JoeGould1878/spectrum_visualiser_lab/docs/evidence/plots/2026-11-05_first_run_frames.png

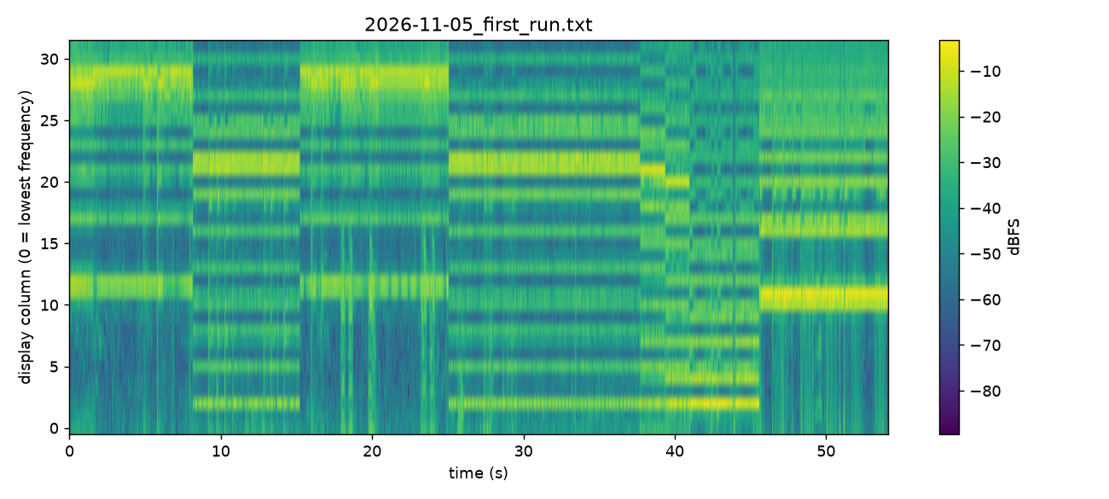
docs/evidence/plots/2026-11-05_first_run_frames.png
