JoeGould1878/spectrum_visualiser_lab/docs/evidence/README.md

# Evidence

Everything here can be cited in reflections, the report and the demo.

| Folder | What goes in it | Name like |
| --- | --- | --- |
| `logs/` | serial captures (`idf.py monitor \| tee`) | `2026-11-03_02_rate_40k.txt` |
| `photos/` | setups, display states, wiring | `2026-11-03_01_staircase.jpg` |
| `videos/` | latency clap, music demo, aliasing demo | `2026-11-10_aliasing_filter_off.mp4` |
| `plots/` | charts made by `tools/` | `2026-11-10_freq_response.png` |

Date first so files sort in order. Mention the file name in `docs/CONTEXT.md` or the decision log when it backs a decision.

Large videos: keep them out of git if they're over ~50 MB (GitHub limit is 100 MB) — upload to Canvas and put the link here instead.
