JoeGould1878/spectrum_visualiser_lab/docs/diagrams/circuit.png

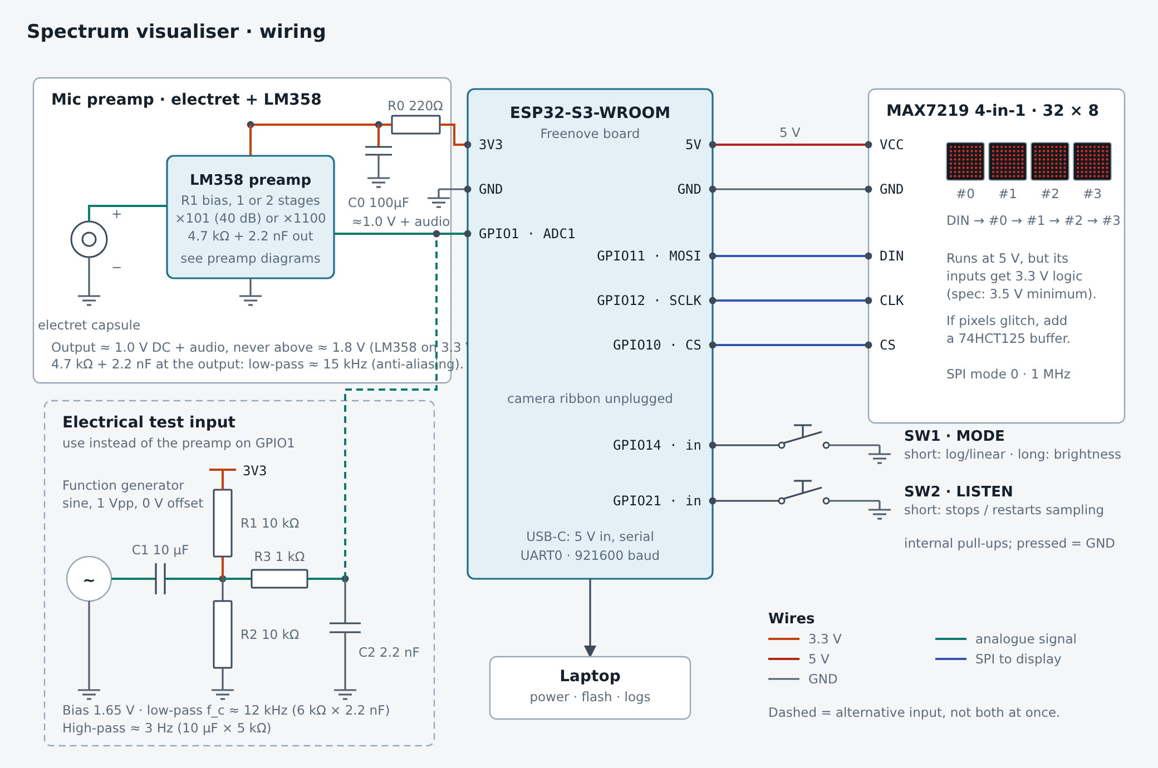
docs/diagrams/circuit.png
