JoeGould1878/spectrum_visualiser_lab/docs/diagrams/fw-detail.png

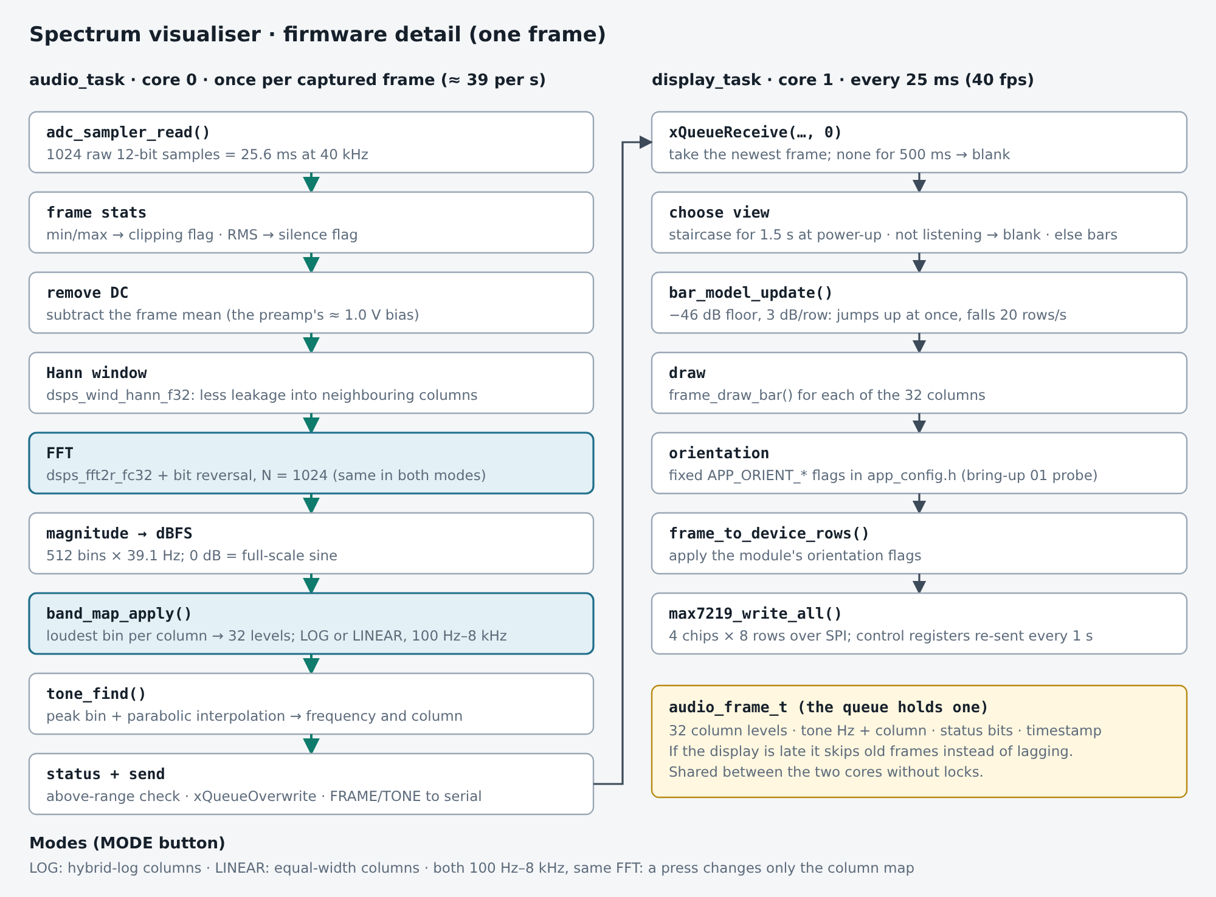
docs/diagrams/fw-detail.png
