JoeGould1878/spectrum_visualiser_lab/docs/diagrams/fw-flow.png

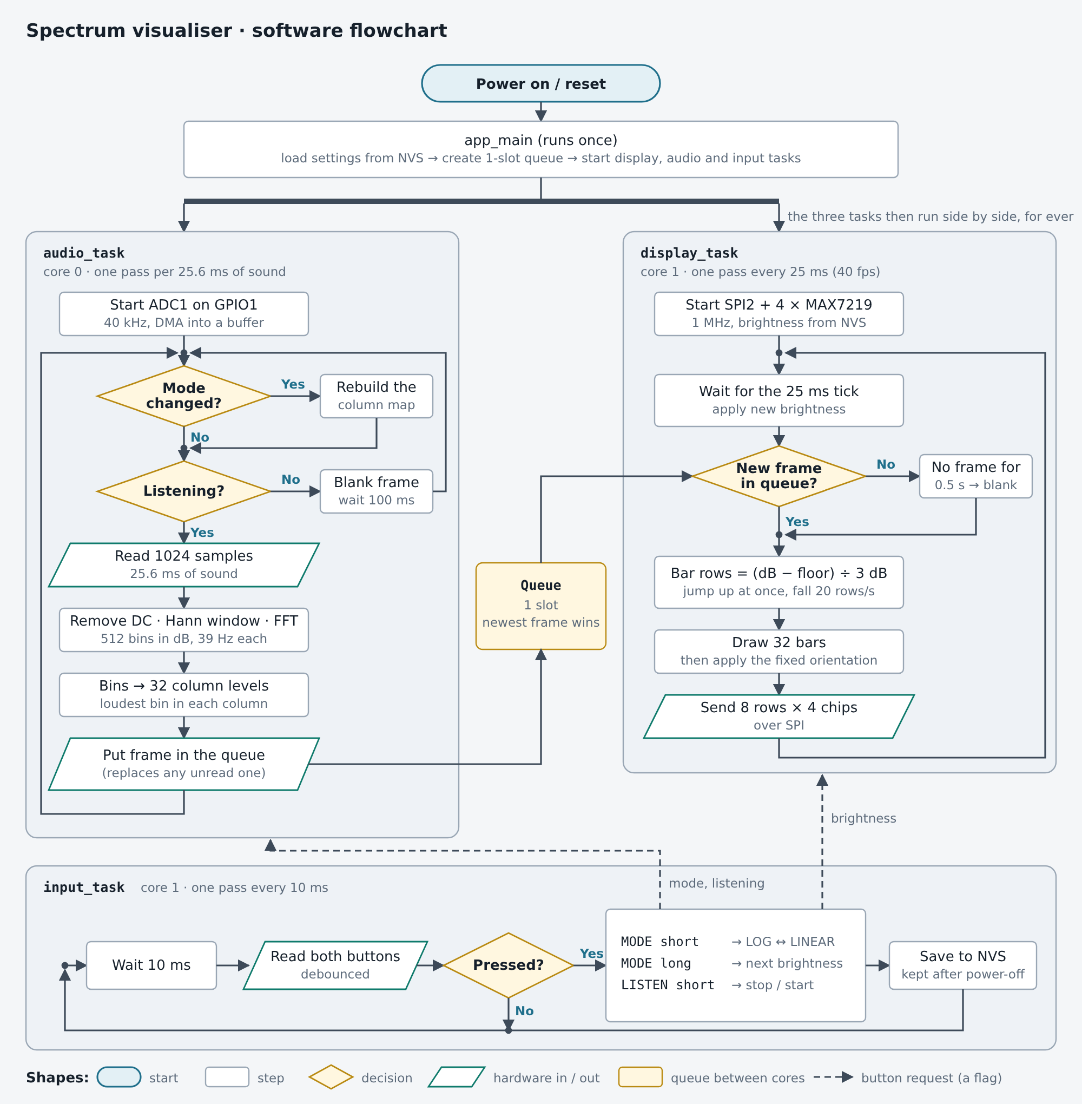
docs/diagrams/fw-flow.png
