JoeGould1878/spectrum_visualiser_lab/docs/diagrams/fw-overview.png

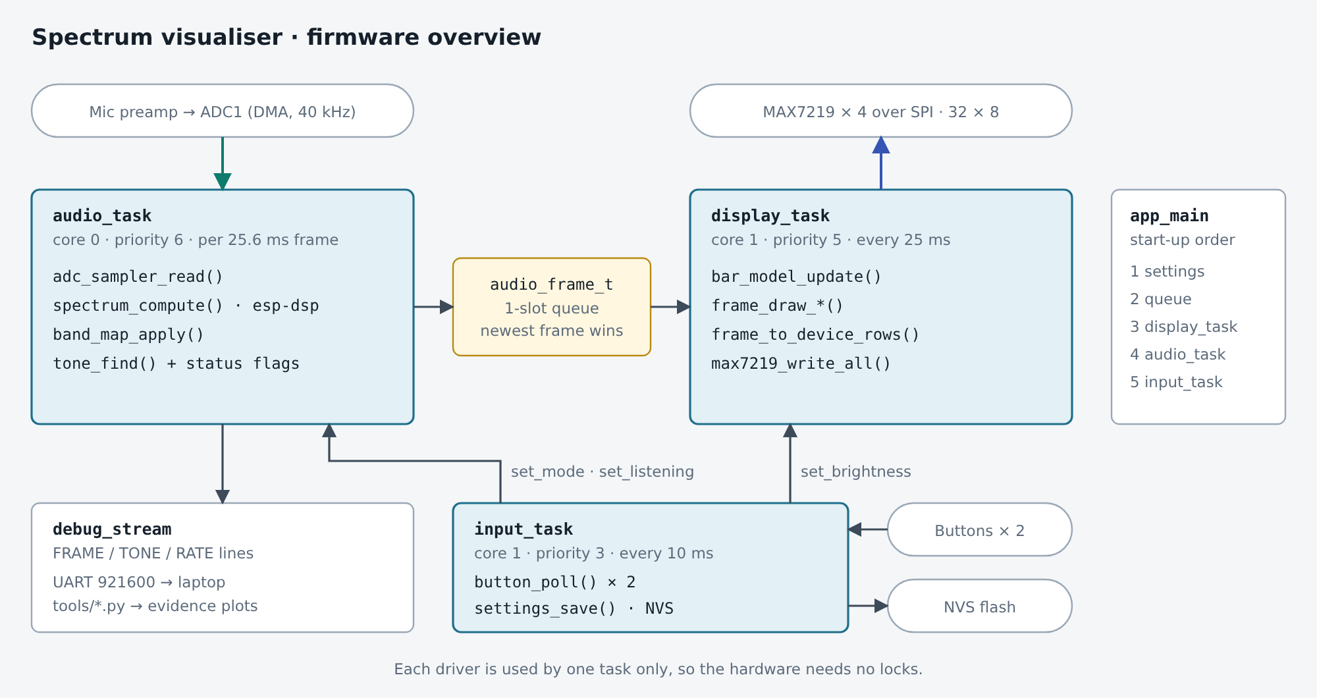
docs/diagrams/fw-overview.png
