JoeGould1878/spectrum_visualiser_lab/docs/diagrams/hw-detail.png

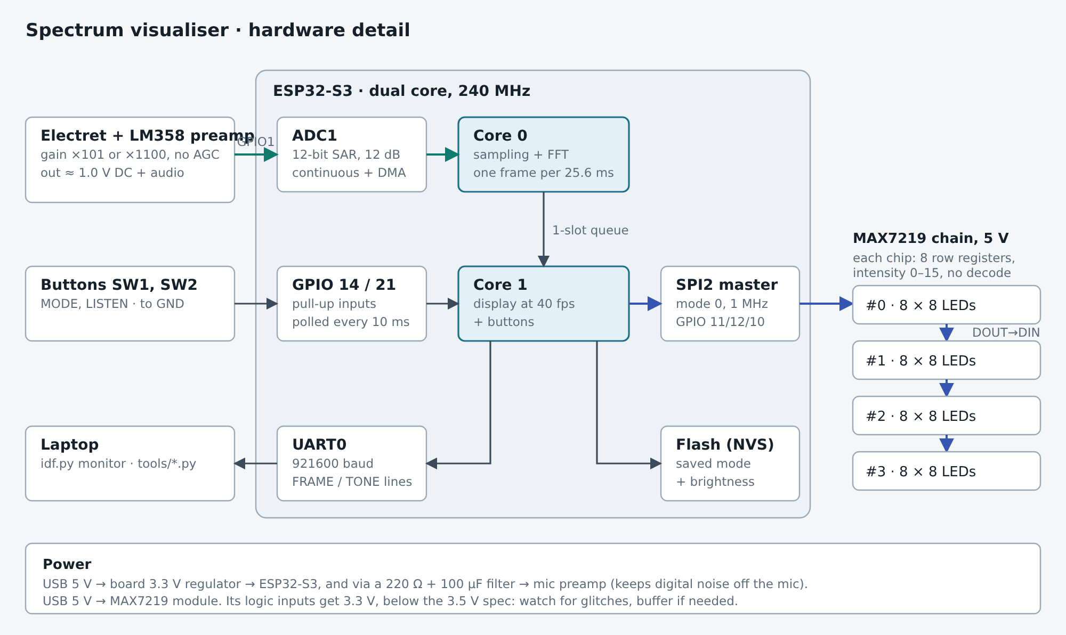
docs/diagrams/hw-detail.png
