JoeGould1878/spectrum_visualiser_lab/docs/diagrams/hw-overview.png

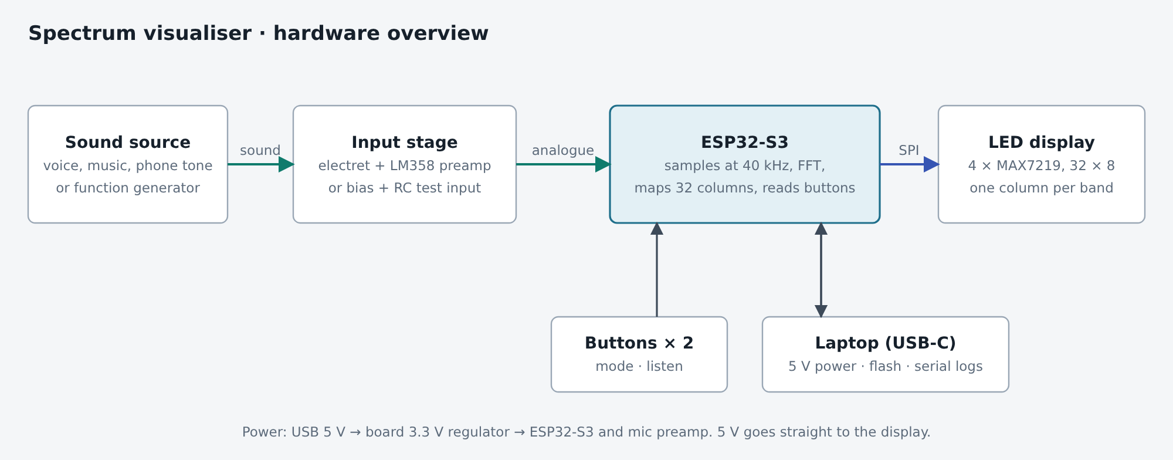
docs/diagrams/hw-overview.png
