JoeGould1878/spectrum_visualiser_lab/docs/diagrams/preamp-2.png

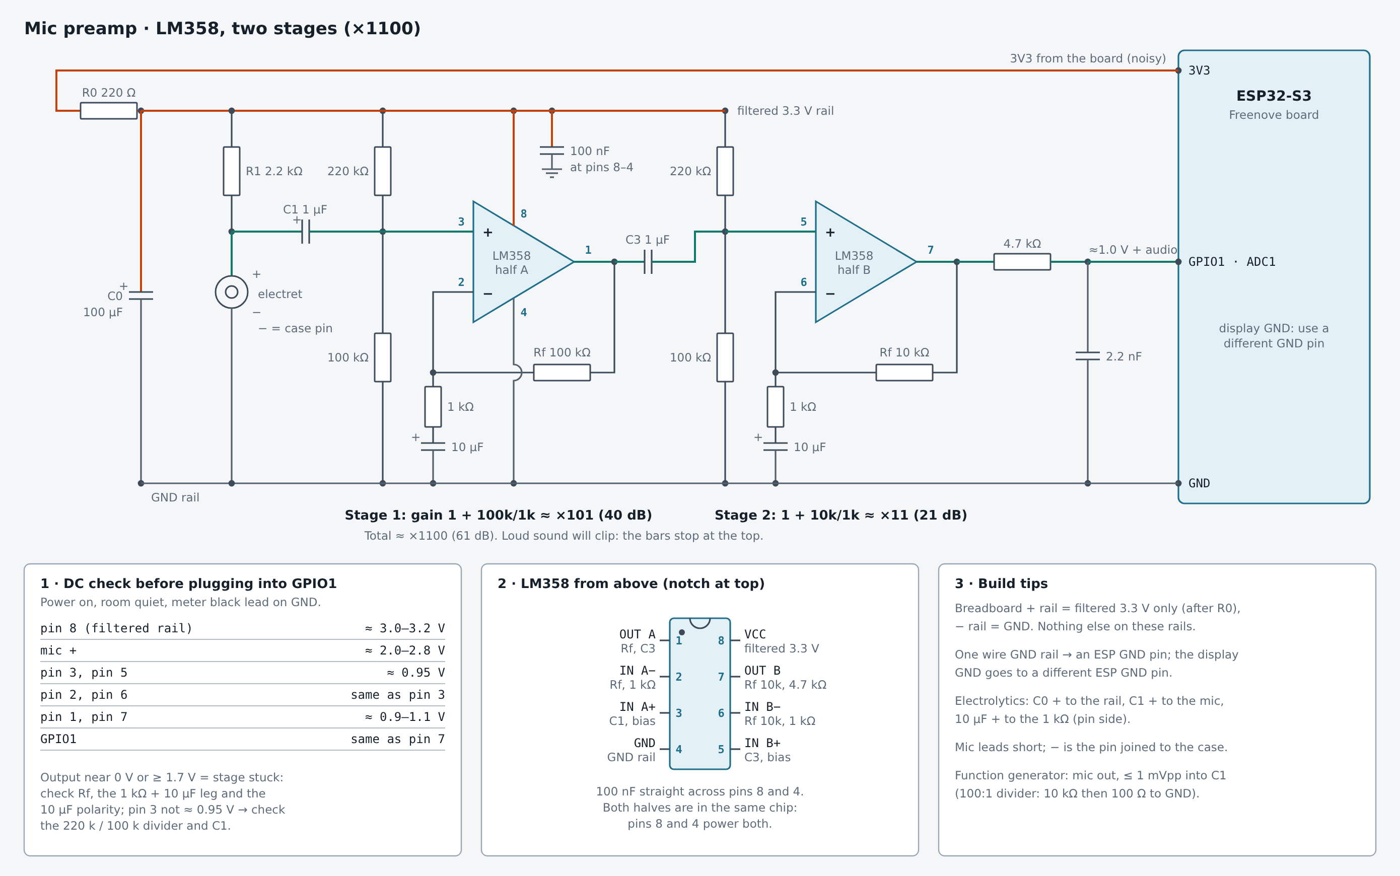
docs/diagrams/preamp-2.png
