JoeGould1878/spectrum_visualiser_lab/docs/diagrams/schematic-kicad.png

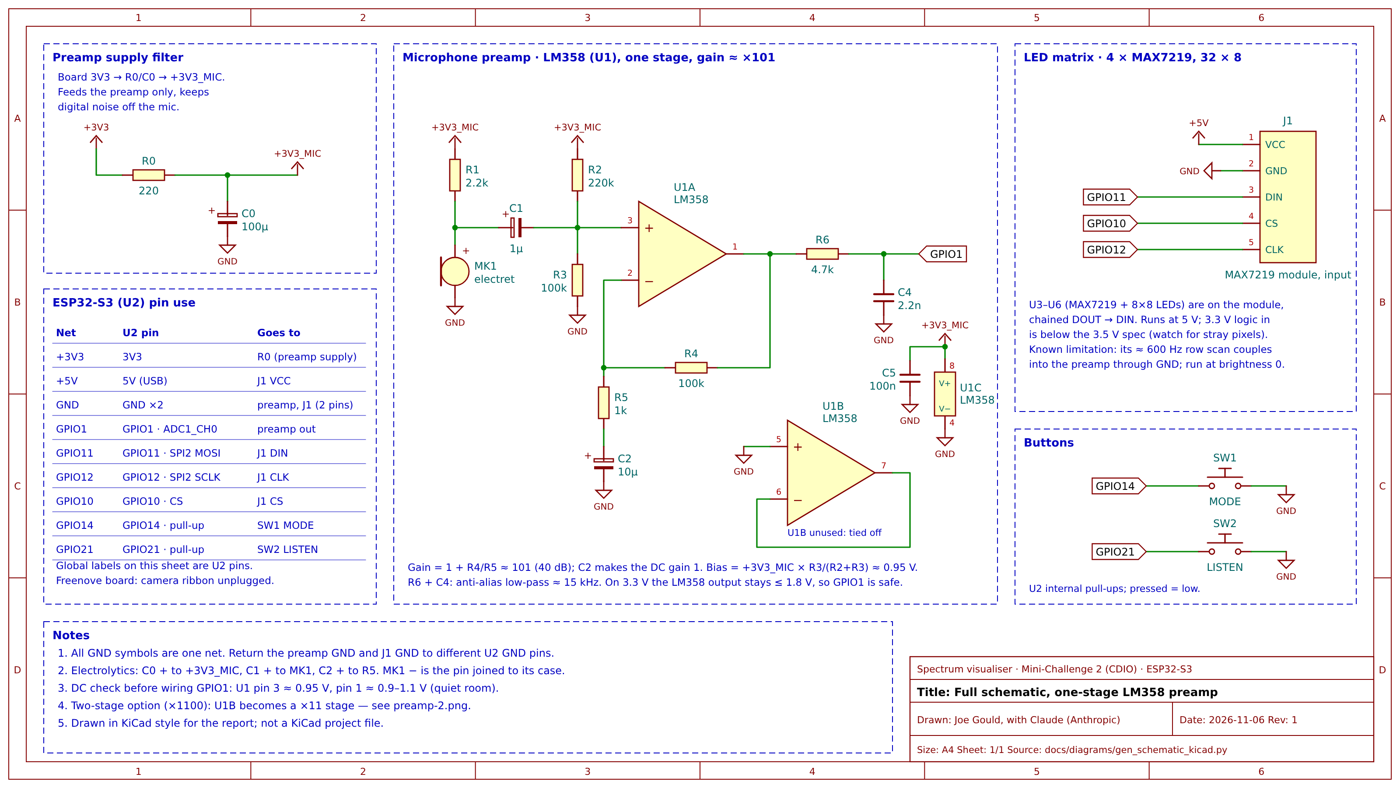
docs/diagrams/schematic-kicad.png
