JoeGould1878/spectrum_visualiser_lab/docs/evidence/plots/2026-10-30_B1_quiet_room_frames.png

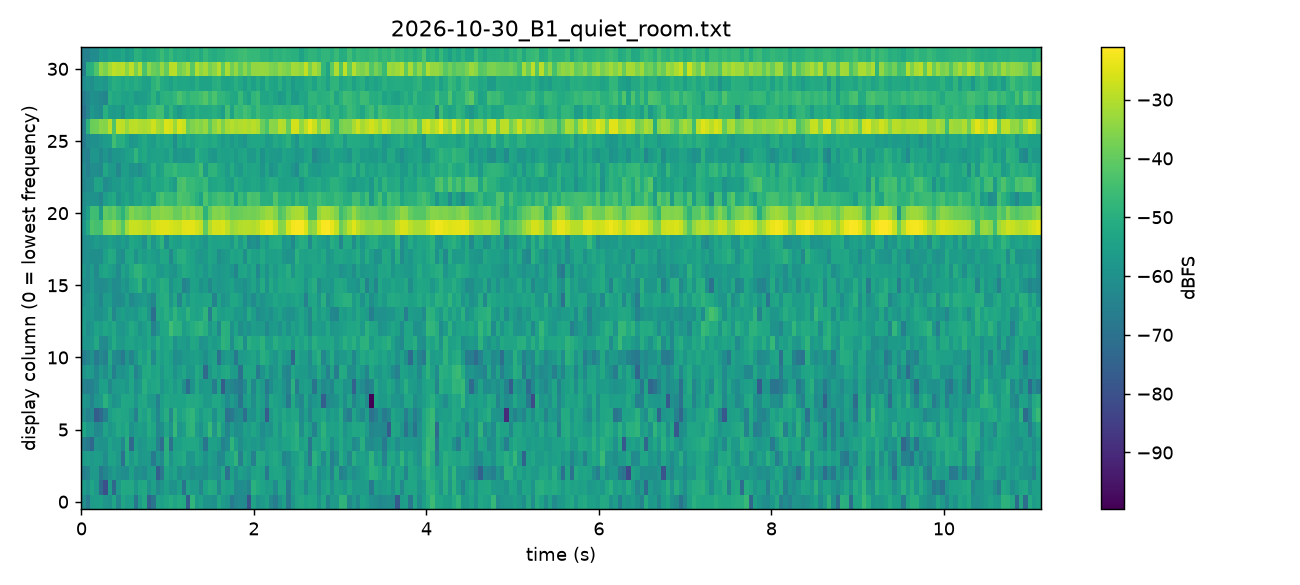
docs/evidence/plots/2026-10-30_B1_quiet_room_frames.png
