JoeGould1878/spectrum_visualiser_lab/docs/evidence/plots/2026-11-05_B1_covered_b15_frames.png

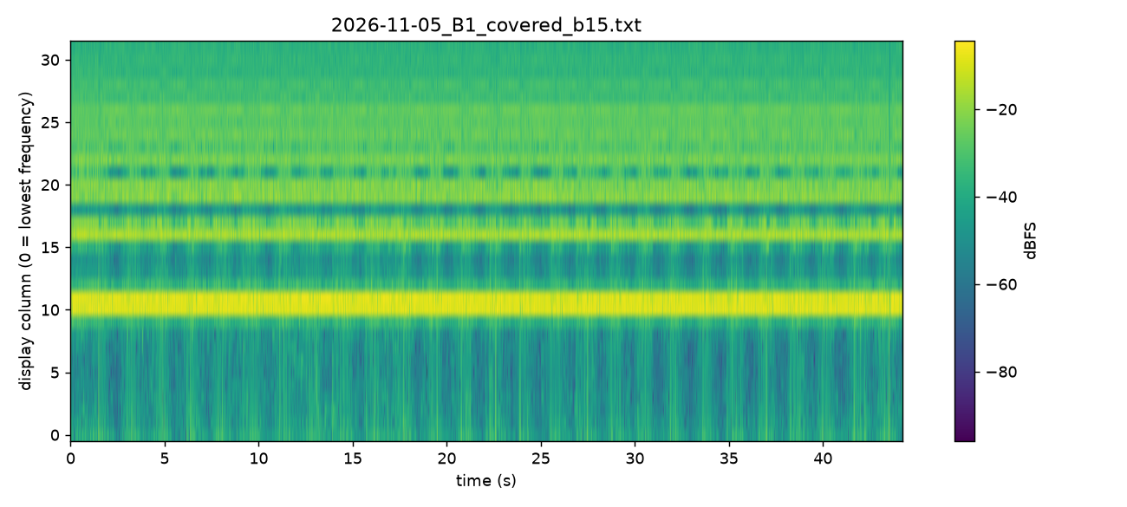
docs/evidence/plots/2026-11-05_B1_covered_b15_frames.png
