JoeGould1878/spectrum_visualiser_lab/docs/evidence/plots/accuracy.png

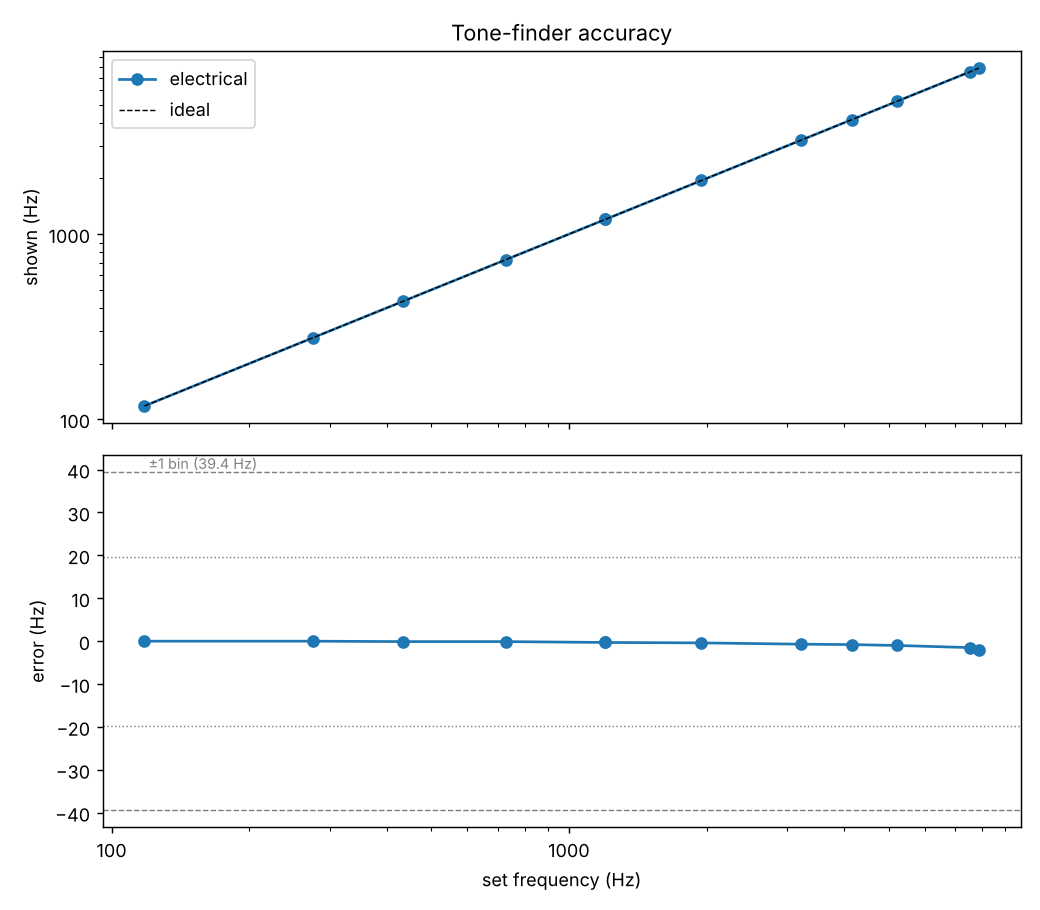
docs/evidence/plots/accuracy.png
