JoeGould1878/spectrum_visualiser_lab/hardware/kicad/spectrum_visualiser.png

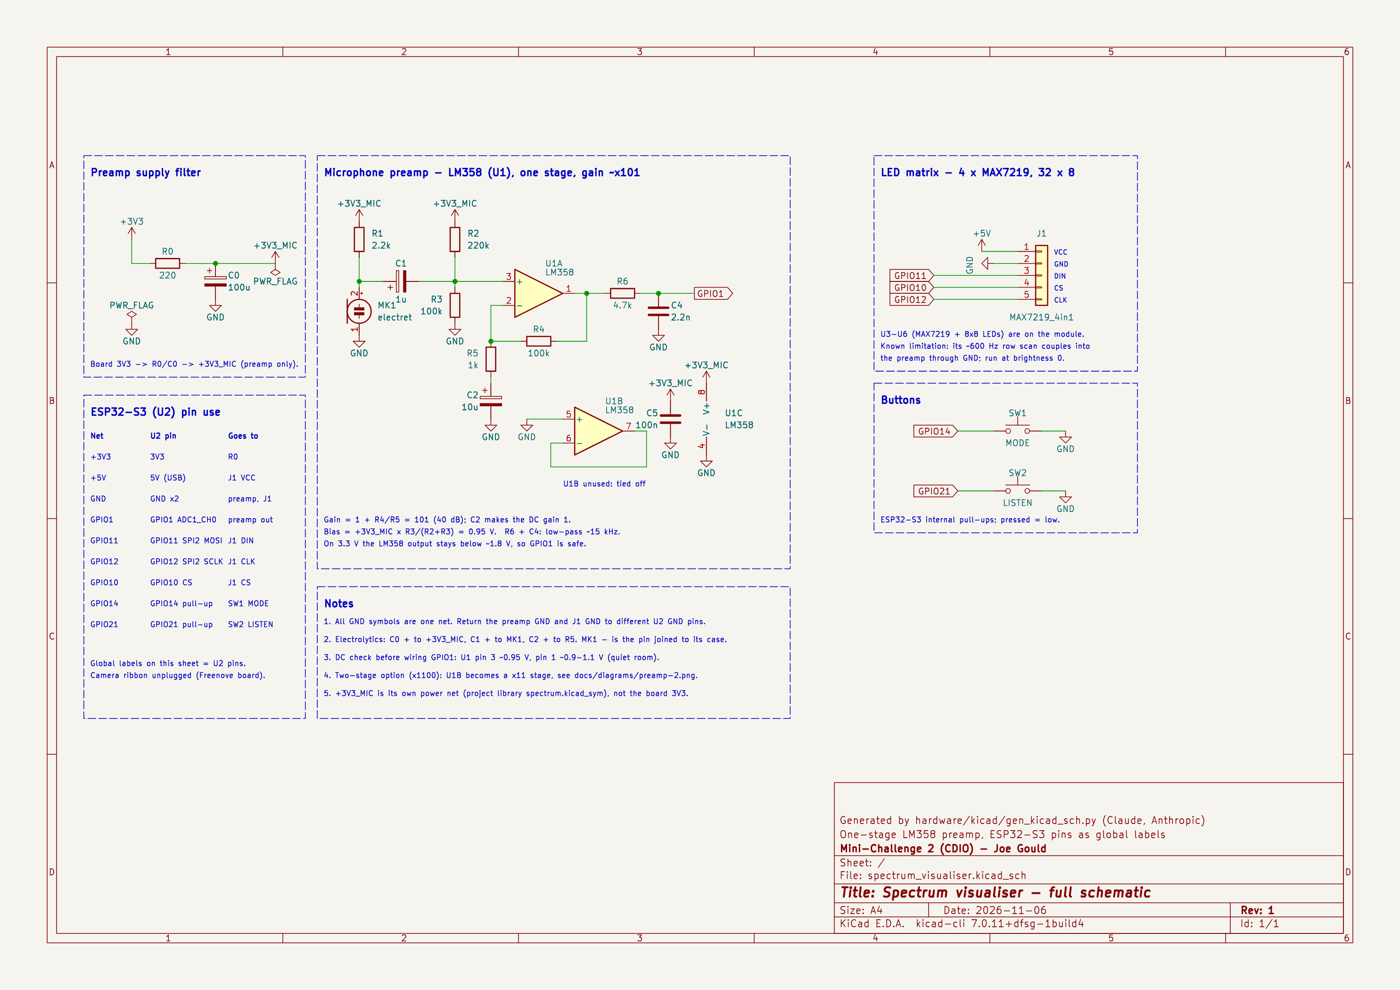
hardware/kicad/spectrum_visualiser.png
