JoeGould1878/spectrum_visualiser_lab/hardware/kicad/spectrum_visualiser.pdf

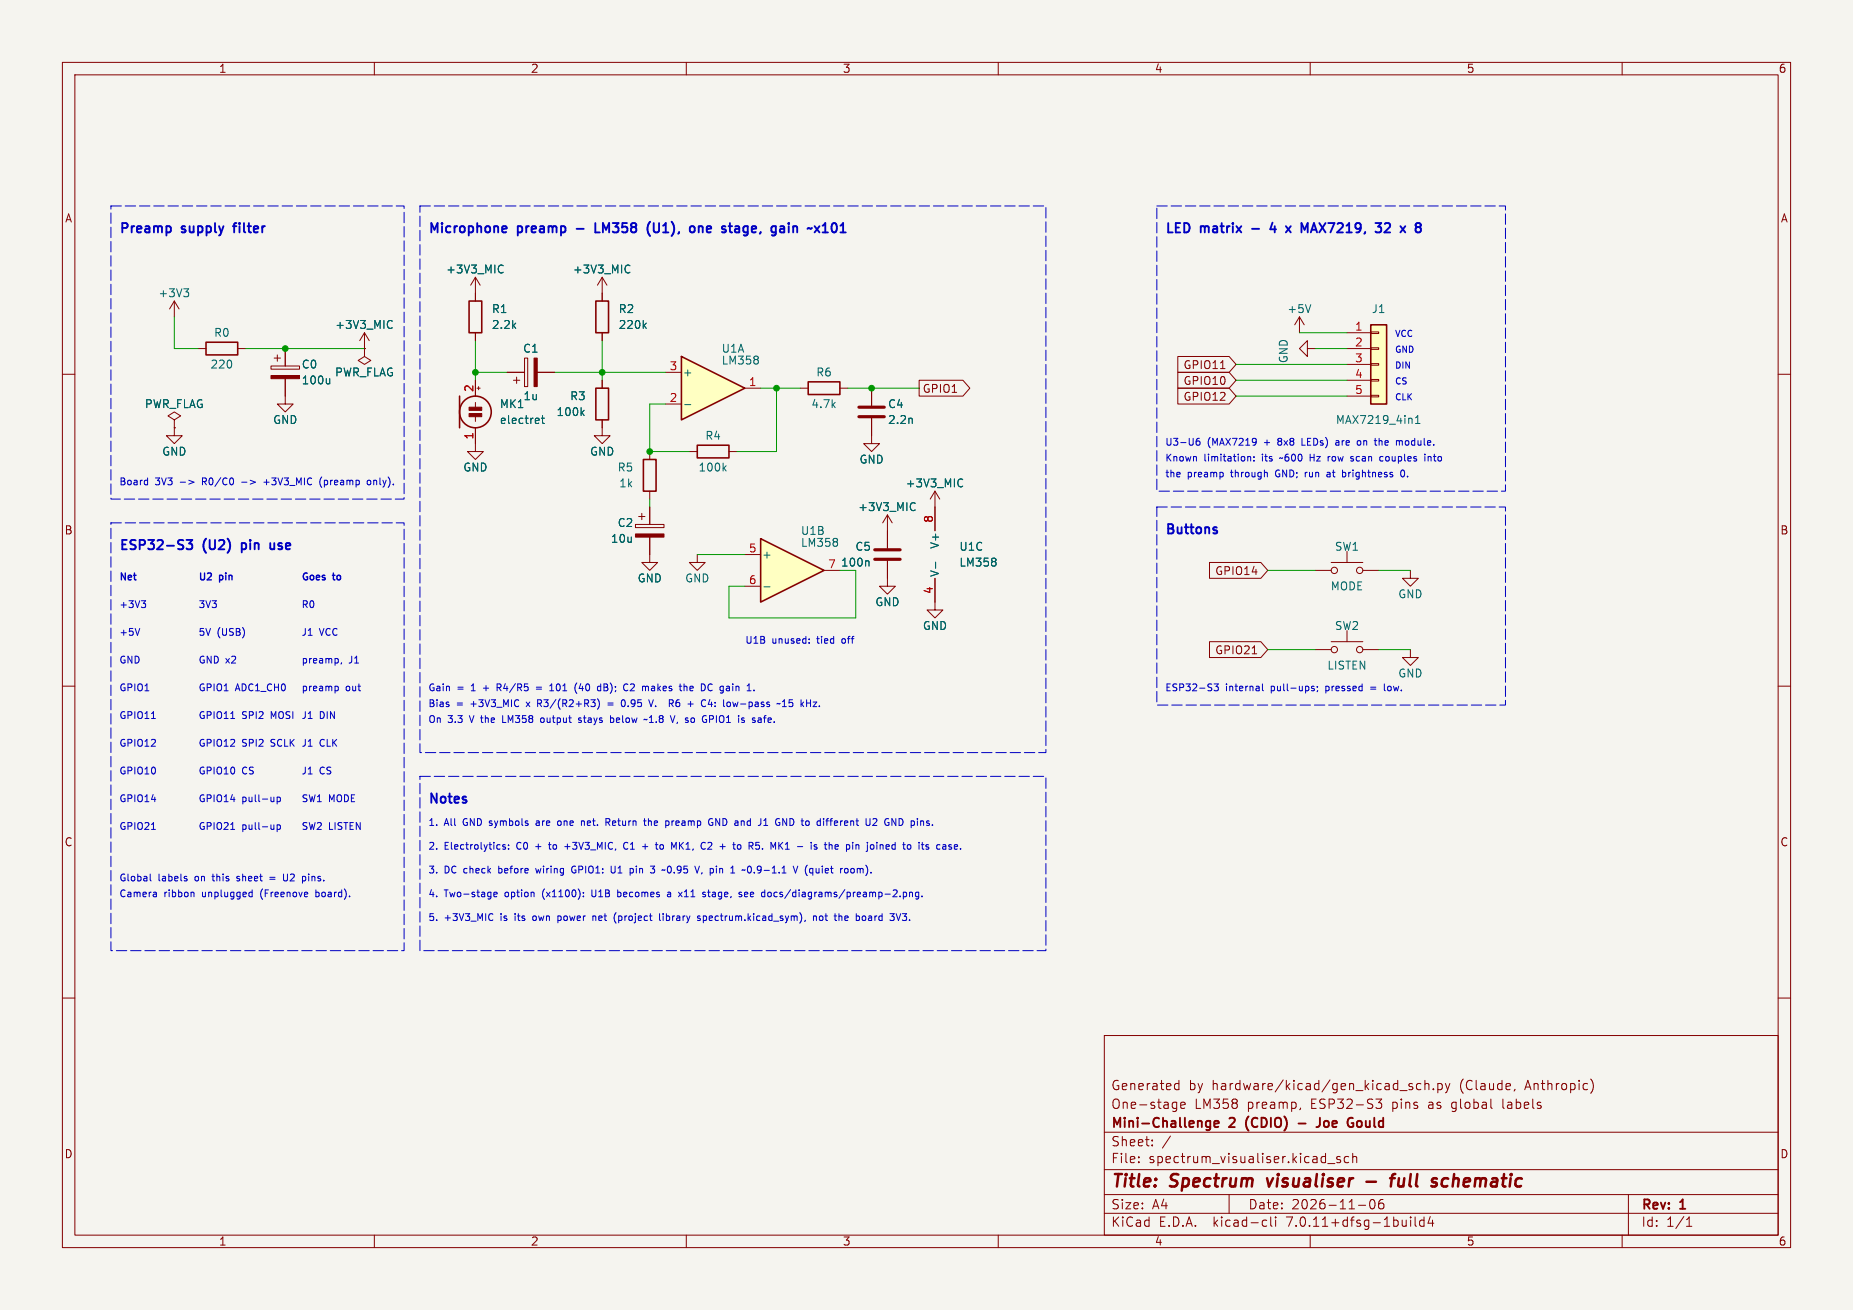
[picture p19: page 1]

Id: 1/1 Title: Spectrum visualiser - full schematic
