JoeGould1878/spectrum_visualiser_lab/hardware/kicad/spectrum_visualiser.kicad_sch

## KiCad design hardware/kicad/spectrum_visualiser.kicad_sch (2026-11-06)

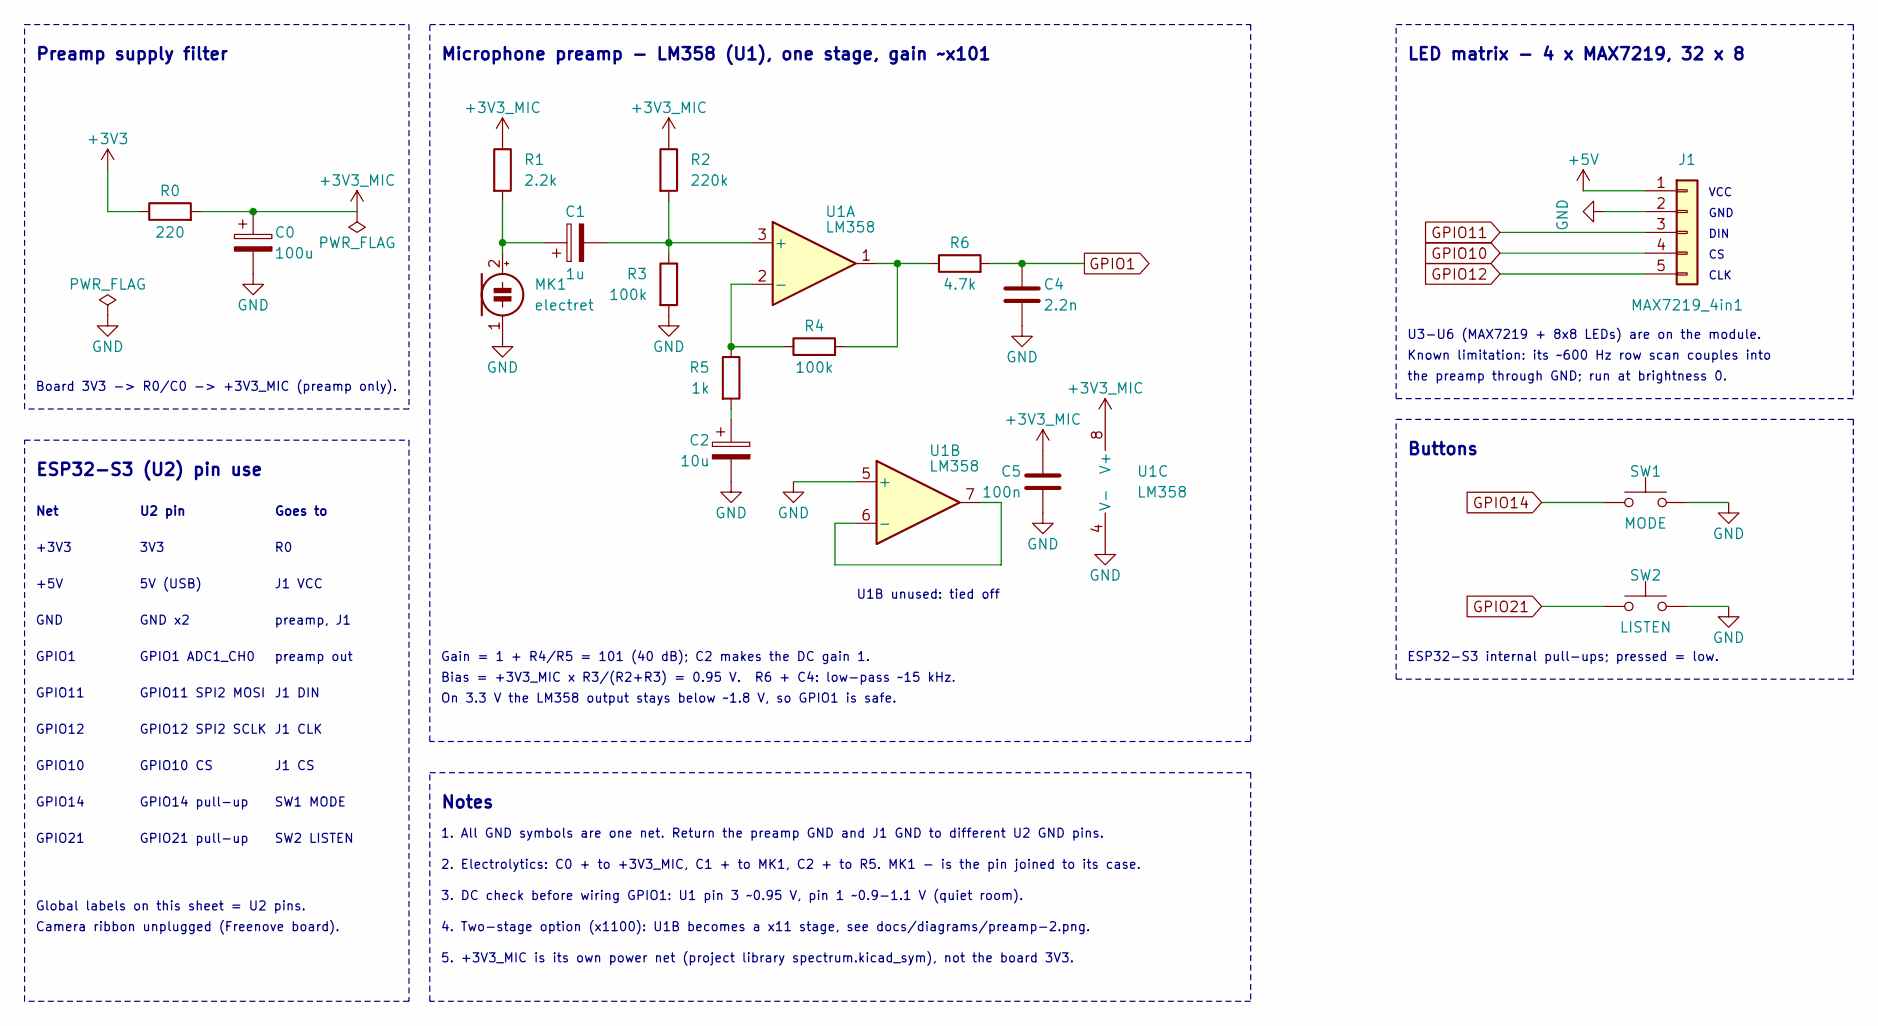
[picture p20: schematic spectrum_visualiser.kicad_sch]

Parts:
C0: 100u
C1: 1u
C2: 10u
C4: 2.2n
C5: 100n
J1: MAX7219_4in1
MK1: electret
R0: 220
R1: 2.2k
R2: 220k
R3, R4: 100k
R5: 1k
R6: 4.7k
SW1: MODE
SW2: LISTEN
U1: LM358

Connections:
+3V3: R0.1
+3V3_MIC: C0.1, C5.1, R0.2, R1.1, R2.1, U1.8 (V+)
+5V: J1.1
GND: C0.2, C2.2, C4.2, C5.2, J1.2, MK1.1 (-), R3.2, SW1.2, SW2.2, U1.4 (V-), U1.5 (+)
GPIO1: C4.1, R6.2
GPIO10: J1.4
GPIO11: J1.3
GPIO12: J1.5
GPIO14: SW1.1
GPIO21: SW2.1
unnamed: C1.1, MK1.2 (+), R1.2
unnamed: C1.2, R2.2, R3.1, U1.3 (+)
unnamed: C2.1, R5.2
unnamed: R4.1, R5.1, U1.2 (-)
unnamed: R4.2, R6.1, U1.1
unnamed: U1.6 (-), U1.7

Notes on the sheet:
VCC
GND
DIN
CLK
Preamp supply filter
Board 3V3 -> R0/C0 -> +3V3_MIC (preamp only).
Microphone preamp - LM358 (U1), one stage, gain ~x101
Gain = 1 + R4/R5 = 101 (40 dB); C2 makes the DC gain 1.
Bias = +3V3_MIC x R3/(R2+R3) = 0.95 V. R6 + C4: low-pass ~15 kHz.
On 3.3 V the LM358 output stays below ~1.8 V, so GPIO1 is safe.
U1B unused: tied off
LED matrix - 4 x MAX7219, 32 x 8
U3-U6 (MAX7219 + 8x8 LEDs) are on the module.
Known limitation: its ~600 Hz row scan couples into
the preamp through GND; run at brightness 0.
Buttons
ESP32-S3 internal pull-ups; pressed = low.
ESP32-S3 (U2) pin use
Net
U2 pin
Goes to
+3V3
3V3
+5V
5V (USB)
J1 VCC
GND x2
preamp, J1
GPIO1
GPIO1 ADC1_CH0
preamp out
GPIO11
GPIO11 SPI2 MOSI
J1 DIN
GPIO12
GPIO12 SPI2 SCLK
J1 CLK
GPIO10
GPIO10 CS
J1 CS
GPIO14
GPIO14 pull-up
SW1 MODE
GPIO21
GPIO21 pull-up
SW2 LISTEN
Global labels on this sheet = U2 pins.
Camera ribbon unplugged (Freenove board).
Notes
1. All GND symbols are one net. Return the preamp GND and J1 GND to different U2 GND pins.
2. Electrolytics: C0 + to +3V3_MIC, C1 + to MK1, C2 + to R5. MK1 - is the pin joined to its case.
3. DC check before wiring GPIO1: U1 pin 3 ~0.95 V, pin 1 ~0.9-1.1 V (quiet room).
4. Two-stage option (x1100): U1B becomes a x11 stage, see docs/diagrams/preamp-2.png.
5. +3V3_MIC is its own power net (project library spectrum.kicad_sym), not the board 3V3.
