JoeGould1878/spectrum_visualiser_lab/main/settings.c

/**
 * @file settings.c
 * @brief NVS settings — implementation.
 *
 * Implementation: Claude (Anthropic), to Joe Gould's design and interface;
 *   reviewed and tested on hardware by Joe Gould
 * Credits / sources used: ESP-IDF NVS documentation (init / erase-and-retry
 *   pattern from the nvs_rw_value example).
 */
#include "settings.h"
#include "app_config.h"
#include "nvs_flash.h"
#include "nvs.h"
#include "esp_check.h"

static const char *TAG = "settings";
#define NVS_NS "sv2"   /* renamed 05/11: old "spectrum" keys (mode 2, orient 9) are ignored */

esp_err_t settings_init(void)
{
    esp_err_t err = nvs_flash_init();
    if (err == ESP_ERR_NVS_NO_FREE_PAGES || err == ESP_ERR_NVS_NEW_VERSION_FOUND) {
        ESP_LOGW(TAG, "NVS partition full or old format: erasing");
        ESP_RETURN_ON_ERROR(nvs_flash_erase(), TAG, "erase");
        err = nvs_flash_init();
    }
    return err;
}

esp_err_t settings_load(settings_t *out)
{
    out->mode = APP_MODE_DEFAULT;
    out->brightness = APP_BRIGHTNESS_DEFAULT;

    nvs_handle_t h;
    esp_err_t err = nvs_open(NVS_NS, NVS_READONLY, &h);
    if (err == ESP_ERR_NVS_NOT_FOUND) return ESP_OK;   /* nothing saved yet */
    ESP_RETURN_ON_ERROR(err, TAG, "open");

    uint8_t v;
    if (nvs_get_u8(h, "mode", &v) == ESP_OK) out->mode = app_mode_valid(v) ? (app_mode_t)v : APP_MODE_LOG;
    if (nvs_get_u8(h, "bright", &v) == ESP_OK && v <= 15) out->brightness = v;
    nvs_close(h);
    ESP_LOGI(TAG, "loaded mode %s, brightness %u", app_mode_name(out->mode), out->brightness);
    return ESP_OK;
}

esp_err_t settings_save(const settings_t *s)
{
    nvs_handle_t h;
    ESP_RETURN_ON_ERROR(nvs_open(NVS_NS, NVS_READWRITE, &h), TAG, "open");
    esp_err_t err = nvs_set_u8(h, "mode", (uint8_t)s->mode);
    if (err == ESP_OK) err = nvs_set_u8(h, "bright", s->brightness);
    if (err == ESP_OK) err = nvs_commit(h);
    nvs_close(h);
    return err;
}
