JoeGould1878/spectrum_visualiser_lab/main/debug_stream.h

/**
 * @file debug_stream.h
 * @brief Machine-readable lines over serial, for logging tests to a file and
 *        plotting in Python (tools/).
 *
 * Design and interface: Joe Gould, drafted with Claude (Anthropic)
 *
 * Plain printf lines (no ESP_LOG prefix) so they are easy to parse; any line
 * not starting with one of these tags is ignored by the tools.
 *
 *   FRAME,<seq>,<t_ms>,<mode>,<status>,<process_us>,<c0_db>,...,<c31_db>
 *   TONE,<seq>,<hz>,<db>
 *   RATE,<measured_sample_rate_hz>
 *   DISPLAY,<fps>,<frame_age_avg_ms>,<frame_age_max_ms>,<write_us>   (once a second)
 *       frame_age = time from end of audio capture to the frame being written
 *       to the matrix (part of the latency budget, R3); write_us = SPI write time
 *   RAW,<n>,<v0>,...,<vn-1>                (bring-up / mic checks only)
 *
 * Bring-up 02 only (printed directly from bringup/02_mic_adc):
 *   RATE_TEST,<requested_hz>,<measured_hz>,<overflows>
 *   STATS,<mean>,<min>,<max>,<rms>          (raw counts; rms after removing the mean)
 *
 * Units: t_ms = ms since boot; c*_db and TONE db = dBFS (0 = full-scale sine);
 * status = frame_status_t bits; mode = app_mode_t number.
 *
 * Capture:  idf.py -p /dev/ttyACM0 monitor | tee docs/evidence/logs/<name>.txt
 */
#pragma once

#include <stdbool.h>
#include <stddef.h>
#include <stdint.h>
#include "app_types.h"

void debug_stream_set_enabled(bool on);
bool debug_stream_enabled(void);

void debug_stream_frame(const audio_frame_t *f);
void debug_stream_rate(float measured_hz);
void debug_stream_display(float fps, float age_avg_ms, float age_max_ms, uint32_t write_us);
void debug_stream_raw(const uint16_t *raw, size_t n);
