JoeGould1878/spectrum_visualiser_lab/(commit log)

2026-10-29 Bring-up 01: MAX7219 driver, frame_gfx, orientation sweep
    - max7219: SPI mode 0, no DMA (<=16 bytes/transfer), one CS-low
    transaction per row register covering the whole chain so all chips
    latch together; 1 MHz to start until the soak test is clean.
    - frame_gfx: pixels, bars, peaks, 3x5 font, provisional status pixels,
    and frame_to_device_rows with 16 orientation combinations. Laptop
    tests check the mapping is 1:1 for every combination.
    - bring-up 01: test mode, raw-bit photos, sweep of all 16 orientations
    (pick the right one from one flash instead of guess-and-reflash),
    then a 5-min soak at the real 40 fps rate logging SPI write time.
    - docs: teaching-lab framing and lab functio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
2026-10-29 adc_sampler + bring-up 02: continuous ADC, rate sweep, raw stream
    - adc_sampler: ESP-IDF continuous (DMA) driver on one ADC1 pin, 12 dB
    attenuation (S3 reads ~0-3.1 V; MAX9814 swings 0.25-2.25 V, 6 dB
    would clip at ~1.75 V). 256-sample conversion frames, ~100 ms pool,
    flush_pool on so a slow reader drops old data instead of stalling.
    - Rate is counted in the driver's frame-done ISR, so it measures what
    the hardware produced, not how fast we read. Added
    adc_sampler_overflows() to the header so gaps in audio are visible.
    - Rejects ADC2 pins and rates outside SOC_ADC_SAMPLE_FREQ_THRES_*
    (S3: 611..83333 Hz).
    - bring-up 02: one flash sweeps 20/40/48/60/80/83.3 kHz (RATE_TEST
    lines),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
    [adc_sampler.c, adc_sampler.h, main.c]
2026-10-29 band_map, bar_model, tone_finder + laptop tests
    - band_map: linear (baseline, equal bins per column) and hybrid log.
    Hybrid splits the remaining range into equal ratios column by column,
    never narrower than one bin; at 39 Hz bins, 100-8000 Hz gives 9
    single-bin columns at the bottom, then log spacing (table printed by
    the test). Bin 0 (DC / mic bias) is never used. Column value = max.
    - bar_model: (dB - floor) / dB-per-row, fast rise, slow fall, peak hold
    then fall. Height truncates, so noise just above the floor lights
    nothing (R5). No auto-gain (MAX9814 already has AGC).
    - tone_finder: loudest bin + parabolic interpolation on dB. Synthetic
    Hann-windowed sines 150 Hz-7.8 kHz c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
2026-10-29 spectrum: DC removal, decimation filter, Hann window, esp-dsp FFT
    - Frame stats (raw min/max for clipping, RMS for silence) on raw data.
    - DC removed with the frame mean (the MAX9814 bias).
    - Bass/voice mode: 63-tap windowed-sinc low-pass (Blackman, cut-off at
    80 % of the new Nyquist) applied before keeping every d-th sample, so
    high frequencies can't fold into the bass columns.
    - Hann window optional (APP_USE_WINDOW) for the leakage test; window
    gain corrected so a tone reads the same dB either way.
    - Output in dBFS: 0 dB = sine filling the 12-bit range.
    - FFT twiddle table built once at the max size; buffers 16-byte aligned
    for the S3's optimised FFT.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
2026-10-29 Decision log: ADC, mapping, bars, tone finder, spectrum choices
    Records every design choice made in commits 81c16af, fdee253 and f92bcea
    with alternatives and reasons, for the report. Flags one change from the
    plan for the team: linear baseline uses N = 1024 and the full-mode range
    so linear vs hybrid differs in one variable only.
2026-10-29 App plumbing: button debounce, NVS settings, debug stream, config
    - button: polled, 30 ms time-based debounce, SHORT/LONG reported once
    on release (long >= 800 ms).
    - settings: NVS init with erase-and-retry, mode + brightness loaded
    with range checks and defaults, saved only on change.
    - debug_stream: FRAME / TONE / RATE / RAW lines as documented in
    debug_stream.h; header now also lists the bring-up 02 lines and units.
    - app_config: actual (measured) sample rate kept separate from the
    requested one, bass-mode FFT size, linear-baseline range, tone-finder
    and above-range thresholds, button timings, brightness steps.
    - app_types: audio_frame_t carries the tone's column for tone-finder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
    [app_config.h, app_types.h, button.c, debug_stream.c, debug_stream.h, settings.c]
2026-10-29 Lab test checklist; confirm listening-at-boot and linear baseline
    docs/LAB_TESTS.md lists every test for the next lab sessions in order:
    command, wiring, what to record, evidence file name, and which MEASURE
    value in app_config.h it sets. Joe confirmed the two flagged decisions.
2026-10-29 audio_task: sample -> spectrum -> columns -> tone -> status, per frame
    - Owns adc_sampler, spectrum and band_map (ownership rule). Mode and
    listening requests arrive as atomics; the task applies them between
    frames (rebuilds spectrum + band map; falls back to full mode if a
    config is invalid).
    - Modes: full (hybrid 100-8000 Hz, N 1024), bass/voice (decimate 4,
    N 512, 50-2500 Hz), tone finder (full-mode analysis), linear baseline
    (same N and range as full, linear columns).
    - Status flags: silent, clipping, energy above the displayed range.
    - Tone found across 50 Hz..Nyquist; tone_col = -1 when off the display.
    - Listening off: ADC stopped and flushed, empty frames with
    NOT_LISTENI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
2026-10-29 display_task: bars, peaks, status pixels, tone digits, latency stats
    - 40 fps refresh on its own timer using the newest frame, so bars fall
    smoothly between audio frames and old frames are skipped.
    - Spectrum modes: bar_model ballistics, peak dot only above the bar.
    - Tone-finder mode: "440Hz" centred, updated 4x/s, marker pixel under
    the tone's full-mode column on the bottom row.
    - Bars reset on mode change and when listening stops.
    - Status area defined (was provisional): top-right 4x2, blanked while
    any flag is set so a status pixel can't be read as a bar top. Tests
    updated.
    - New DISPLAY debug line once a second: refresh rate, frame age (end of
    capture -> LEDs written), SPI wri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
    [debug_stream.c, debug_stream.h, display_task.c]
2026-10-29 input_task + main: buttons, start-up order — firmware complete
    - input_task: MODE short = next mode, MODE long = next brightness step,
    LISTEN = stop/start listening; mode and brightness saved on change.
    input_task_start() now takes the loaded settings (header change) so
    the first press steps from the saved state.
    - main: settings -> 1-slot frame queue -> display -> audio -> input,
    and a boot line listing the key config so every log records it.
    - Works with no buttons wired (pull-ups), so testing can start early.
    - Decision log and lab checklist updated.
    [input_task.c, input_task.h, main.c]
2026-10-29 tools: log parser, rate table, raw plot, frame summary, tone accuracy
    - logparse.py: reads raw idf.py monitor captures, ignores anything that
    isn't a debug_stream line (ANSI codes, ESP_LOG output, cut-off lines).
    - rate_table.py (A2): requested vs measured rate, Markdown table.
    - plot_raw.py (A2): bias / clipping / noise summary, waveform + spectrum
    in the firmware's dBFS reference.
    - frames.py (B1, B2): frame rate, processing time, latency stats,
    status-flag %, per-column levels, suggested APP_FLOOR_DB, heatmap.
    - tone_stats.py + plot_accuracy.py (B3, B4): median shown Hz vs set Hz
    per tone into a CSV, then table + error plot against +/- 1/2 and 1 bin.
    - capture.sh: dated evidence l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
2026-10-29 Review fixes: tone-finder edge, stale display, MAX7219 resync, stacks
    From a full read-through before the first hardware run:
    - tone_finder: don't interpolate using a bin below min_bin (a loud DC
    bin could pull the estimate below the search range); clamp offset.
    New host test fails on the old code, passes now.
    - display_task: blank after 500 ms with no audio frame instead of
    freezing; re-send MAX7219 control registers once a second.
    - max7219: new max7219_resync() (header change) — a glitch on the
    3.3 V data line can flip shutdown/test/scan-limit; this recovers.
    Bring-up 01 doesn't use it, so glitches stay countable there.
    - audio_task: 10 ms back-off on ADC read errors (no busy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
    [adc_sampler.c, app_config.h, audio_task.c, display_task.c, max7219.c, max7219.h]
2026-10-29 Docs review fixes: input filter cap 15 nF -> 2.2 nF, lab notes
    The proposed electrical-path low-pass ignored the bias divider's 5 kOhm
    in series with the 1 kOhm resistor: 15 nF gave ~1.8 kHz cut-off, not
    10.6 kHz. 2.2 nF gives ~12 kHz. Lab checklist now uses the firmware's
    boot-time column table for R2, and notes the bring-up 01 reflash wait.
    Decision log: review fixes, and corrected flush_pool behaviour.
2026-10-29 Added wiring, hardware, and firmware diagrams (PNG + SVG + generator); fix aliasing test cap to 2.2nF
    [gen_diagrams.py]
2026-10-30 main/app_config.h updated noise floor db based on test data
    [app_config.h]
2026-10-30 Mic: electret capsule + one-NPN preamp (MAX9814 not available)
    The kit has a bare electret capsule and no op-amp, so the mic input is now a
    common-emitter NPN stage with collector-feedback bias: R1 2.2k capsule bias,
    C1 1u, RB 470k, RC 4.7k, C2 2.2n anti-alias (~15 kHz with RC), rail filtered
    by 220R + 100u. Bias point checked for beta 100-400: collector 1.1-1.9 V,
    gain x33-53 (30-34 dB). A 1k rail resistor was rejected: its drop pulled the
    collector to ~1 V.
    No firmware logic changes (comments only). Updated: wiring/hardware/firmware
    diagrams, bring-up 02 parts table and checks, LAB_TESTS A2/B4, PLAN (design
    table, risks, decision log), CONTEXT, README, CLAUDE.md.
2026-10-30 Fix rotated display and dead response; flag display interference
    Display: bars ran along the strip because the orientation flags were never
    set. Orientation is now chosen on the board: LISTEN long press steps k 0-15
    (bring-up 01 numbering), shows a test staircase, saves to NVS. Default is
    transpose-only, from the 30/10 photos. A test staircase also shows for 1.5 s
    at power-up. LISTEN short press still stops/starts listening.
    Levels: the 30/10 quiet-room log has peaks at 700/1400/2100/2800 Hz, 25-30 dB
    above the room: the MAX7219 row scan coupling into the mic preamp. frames.py
    used the loudest column as the floor, giving -21 dB, so no real sound could
    light a row. Floor now -46 dB (typical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
    [app_config.h, display_task.c, display_task.h, input_task.c, main.c, settings.c, settings.h]
2026-10-30 Display: plain spectrum bars only
    Bench run showed the board left in tone-finder mode (digits) plus status
    pixels, which read as garbage. Per Joe, the display now draws bars only:
    tone-finder mode, status pixels and peak dots are off behind APP_SHOW_*
    flags, and the power-up staircase is off (orientation changes still show
    it). MODE cycles full -> bass/voice -> linear; a saved tone-finder mode
    loads as full. TONE lines and status bits are still computed and logged, so
    tools and accuracy tests are unchanged.
2026-11-05 Diagrams: LM358 preamp (one and two stage) schematics, software flowchart
    The NPN stage gave weak bars, so the preamp is now an LM358 on the
    filtered 3.3 V rail (gain x101, optional second stage x11). Each
    schematic sheet carries the DC voltages to check and the chip pinout,
    for a clean rebuild. Added a high-level software flowchart, and brought
    the wiring, hardware and firmware-detail diagrams and the docs in line
    with the LM358 and the plain-bars display.
    Claude-Session: https://claude.ai/code/session_01KphxczGsKZZveeQgJP8CJN
2026-11-05 Spec: simplify the display to one mode and a fixed orientation
    Joe's 5 Nov bench run: sound response is good with the LM358, but the
    16-way orientation button, the saved orientation in NVS and the
    bass/linear modes make the display look random. The spec replaces the
    orientation sweep with a 4-LED register probe that decides the flags,
    fixes them at compile time, and leaves one display mode.
    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
2026-11-05 Spec: two display modes, LOG and LINEAR, both horizontal
    Joe wants a log axis and a linear axis to switch between, not a single
    mode. Both use the same FFT and 100 Hz-8 kHz range, so a MODE press only
    changes the column map. That makes the log-vs-linear decision visible
    live in the demo. Brightness moves to the MODE long press.
    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
2026-11-05 Bring-up 01: replace 16-way orientation sweep with a 4-LED probe
    Picking an orientation by eye from 16 staircases left two "almost right"
    candidates and a wrong one ended up saved. The probe lights O = dev0 reg0
    bit0, then adds bit 7, reg 7 and dev 1, so three answers (P2 and P3
    direction from O, module of O) fix all four frame_orient_t flags with no
    guessing. The README holds the answer -> flags table and sanity checks.
    A host test writes the table out independently of frame_to_device_rows()
    and checks, for all 16 flag sets, that O/P2/P3/P4 land on the registers
    the probe lights, so the table and the mapping code cannot disagree.
    Spec: docs/specs/2026-11-05_display_simplify.md T1.
    Co-Aut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
    [main.c]
2026-11-05 CONTEXT: log T1 (orientation probe) done
2026-11-05 Firmware: fixed orientation from the probe, two modes (LOG/LINEAR), bars only
    Orientation (spec T2): APP_ORIENT_* set from the 05/11 bring-up 01 probe
    (strip horizontal, wire end on the right): O top-right of the rightmost
    module, P2 left of O, P3 below O, P4 in the next module left ->
    REVERSE_DEVICES=1 FLIP_X=0 FLIP_Y=1 TRANSPOSE=0. Removed the runtime
    orientation (display_task_set_orientation, LISTEN long press, NVS key,
    APP_ORIENT_DEFAULT_K, APP_STAIRCASE_ORIENT_MS): a wrong saved value kept
    coming back after reflashing. A 1.5 s staircase at power-up is the check.
    Modes (T3): app_mode_t is now APP_MODE_LOG = 0 and APP_MODE_LINEAR = 3
    (old numbers, so FRAME logs keep their meaning; logpar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
    [app_config.h, app_types.h, audio_task.c, audio_task.h, display_task.c, display_task.h, input_task.c]
2026-11-05 Docs and diagrams: two modes, fixed orientation, new button map
    Brings the evidence trail in line with the firmware change (spec T7):
    - PLAN decision log: rows for the probe, the orientation result with its
    evidence files, no NVS orientation, LOG/LINEAR, button map, NVS
    rename, removed modes and the boot staircase.
    - LAB_TESTS: Session B controls paragraph, A1 probe result, B1/B3/B4/B5
    checklists and the values-to-measure table. Notes that the 30/10
    quiet-room log behind APP_FLOOR_DB was taken in bass/voice mode with
    the old NPN preamp, so B1 has to be redone.
    - README controls, CLAUDE.md hardware note, CONTEXT log/progress.
    - Diagrams: input lane (3 actions, request labels), displ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
    [gen_diagrams.py]
2026-11-05 Evidence: first run of the simplified firmware
    Log shows the fixed orientation at boot, every button action (LOG/LINEAR
    toggle, brightness steps, listen off/on) and 38.9 frames/s, 14.7 ms
    average frame age. CONTEXT updated with the numbers and next lab steps.
2026-11-05 Evidence: B1 covered-mic log shows display interference dominates
    With the mic covered (brightness 15), columns 10-11 read -5.5 dB and the
    strongest tone is ~600 Hz in nearly every frame, with 10 % clipping: the
    MAX7219 row scan coupling into the x101 LM358 preamp, not sound.
    APP_FLOOR_DB is deliberately left at -46 dB; raising it to the suggested
    -26 dB would hide real sound to mask a wiring fault.
    logparse.py now keeps only the last boot in a log: idf.py monitor resets
    the board on connect, and lines from the previous run made frames.py
    report a negative duration.
2026-11-05 Evidence: display interference scales with brightness (~27 dB, 15 vs 0)
    Covered-mic logs at brightness 15 and 0: worst column -5.8 -> -32.8 dB
    p95, typical column -29.9 -> -42.6 dB, clipping 7 % -> 0 %. The SPI data
    is the same at both levels, so the coupling is the LED current pulses
    on the shared supply/ground, not the data wires. Recorded in
    bringup/README.md next to the wiring fixes; APP_FLOOR_DB unchanged
    until those are done.
2026-11-05 Accept display interference as a known limitation; set floor from B1
    Joe can't rework the wiring in the time left, so the MAX7219 row-scan
    interference stays and is documented with its numbers instead.
    - APP_BRIGHTNESS_DEFAULT 2 -> 0: interference is ~27 dB lower than at
    brightness 15 (2026-11-05_B1_covered_b15/b0.txt).
    - APP_FLOOR_DB -46 -> -40 dB, APP_TONE_MIN_DB -36 -> -30 dB, from the
    covered-mic log at brightness 0 (typical column p95 -42.6 dB + 3 dB).
    The old -46 came from the NPN preamp in bass/voice mode. Interference
    columns 11-12 and 28-29 are excluded and still show ~2 rows in silence.
    - PLAN decision log, LAB_TESTS, bringup/README, CONTEXT updated; the
    display-simplify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
    [app_config.h]
2026-11-06 Diagrams: KiCad-style full schematic with ESP32 pins as global labels
    One sheet for the report: one-stage LM358 preamp, supply filter, LED
    module header and buttons, with power symbols and global labels instead
    of a large MCU block, plus a U2 pin table, notes and a title block.
    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
2026-11-06 Sample rate 40314 Hz from logs; B3 procedure; real KiCad schematic
    - APP_SAMPLE_RATE_ACTUAL_HZ 40000 -> 40314: median of 172 RATE lines in
    the 05/11 logs. At 40000 all Hz maths was 0.8 % low, about one bin at
    5 kHz, which could fail an R2 edge case.
    - LAB_TESTS B3: step-by-step procedure, test tones at the centre of
    every 4th column at the measured rate (LOG and LINEAR), aliasing tones
    25/35/38 kHz (25 and 30 kHz alias above the 8 kHz display, so they
    can't show R6 failing).
    - hardware/kicad: KiCad 7 project generated from the standard symbol
    libraries, ESP32 pins as global labels, a +3V3_MIC power symbol in a
    project library. Exported netlist checked net by net; PDF and PNG fo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
    [spectrum_visualiser.kicad_sch]
2026-11-06 B3: first column-accuracy results; tools record the mode and expected column
    The FRAME lines show the 'log_' logs were recorded in LINEAR and the
    'lin_' logs in LOG (the board started in its saved LOG mode, so the
    first MODE press went to LINEAR). Logs renamed to the mode they really
    ran in. All 12 tones land in the expected column; shown frequency is
    within 0.03 % (spread 0.3-0.5 Hz, bins 39.4 Hz).
    tone_stats.py now reads the mode from the FRAME lines and the expected
    column from the log's own 'columns (Hz):' line, prints both, and flags
    a wrong column, so a mode mix-up shows up straight away. accuracy.csv
    and plots/accuracy.png built from the 12 logs.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
    [accuracy.csv]
