JoeGould1878/spectrum_visualiser_lab/docs/evidence/photos/2026-11-05_A1_Probe_P4.jpeg

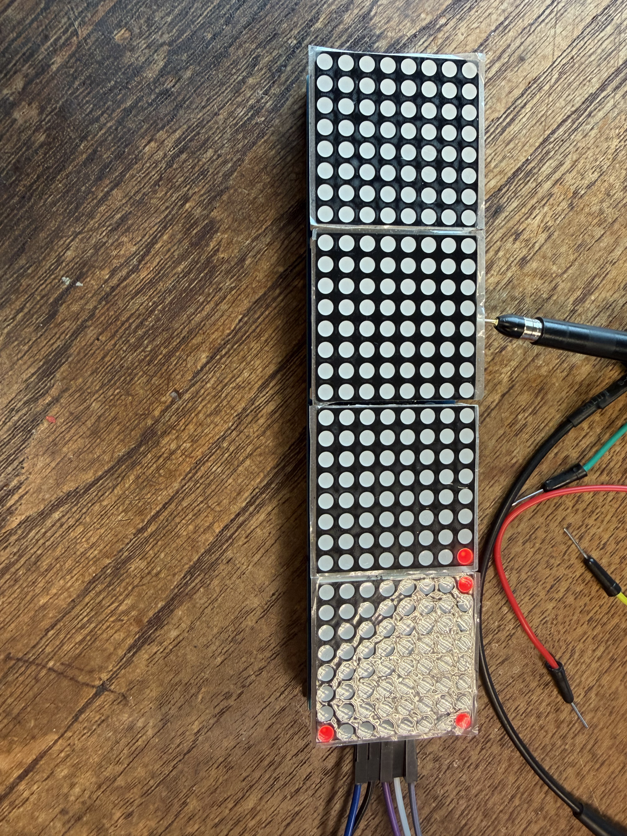
docs/evidence/photos/2026-11-05_A1_Probe_P4.jpeg
